SeanDS/environment-sensor/README.md

# environment-sensor
Ethernet-enabled dust particle, temperature and humidity sensor module
