SeanDS/environment-sensor/hardware/environment-sensor.kicad_pcb

## KiCad design hardware/environment-sensor.kicad_pcb (2017-10-11)

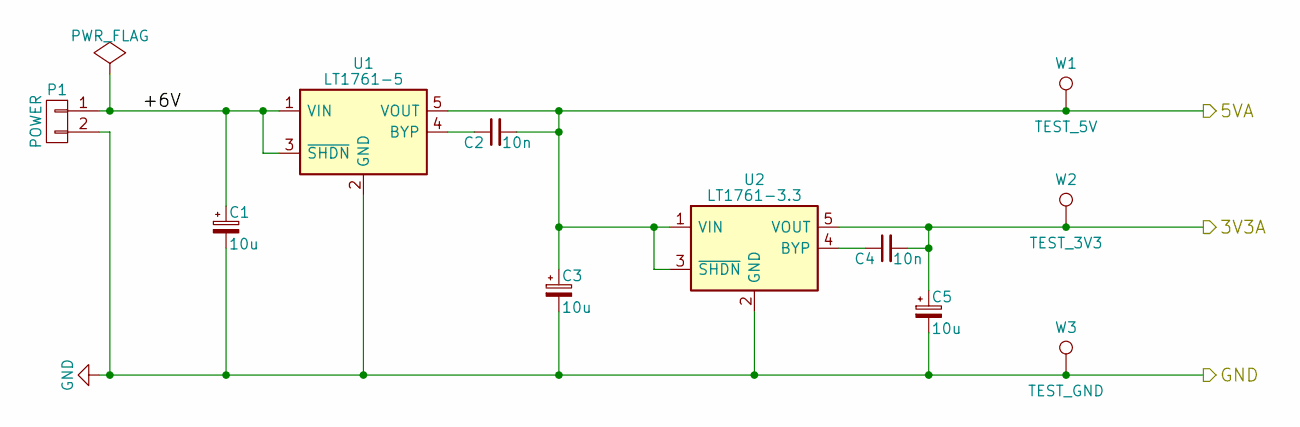
[picture p1: schematic power.sch]

Parts:
C1, C3, C5: 10u; C_Radial_D5_L11_P2
C2, C4: 10n; C_1206
P1: POWER; Molex_KK-6410-02_02x2.54mm_Straight
U1: LT1761-5; SOT-23-5
U2: LT1761-3.3; SOT-23-5
W1: TEST_5V; PINTST
W2: TEST_3V3; PINTST
W3: TEST_GND; PINTST

Connections:
/Microcontroller/3V3A: C4.2, C5.1, U2.5 (VOUT), W2.1; also elsewhere on the board
/Microcontroller/5VA: C2.2, C3.1, U1.5 (VOUT), U2.1 (VIN), U2.3 (~SHDN), W1.1; also elsewhere on the board
/Power Supply/+6V: C1.1, P1.1, U1.1 (VIN), U1.3 (~SHDN)
GND: C1.2, C3.2, C5.2, P1.2, U1.2 (GND), U2.2 (GND), W3.1; also elsewhere on the board
unnamed: C2.1, U1.4 (BYP)
unnamed: C4.1, U2.4 (BYP)

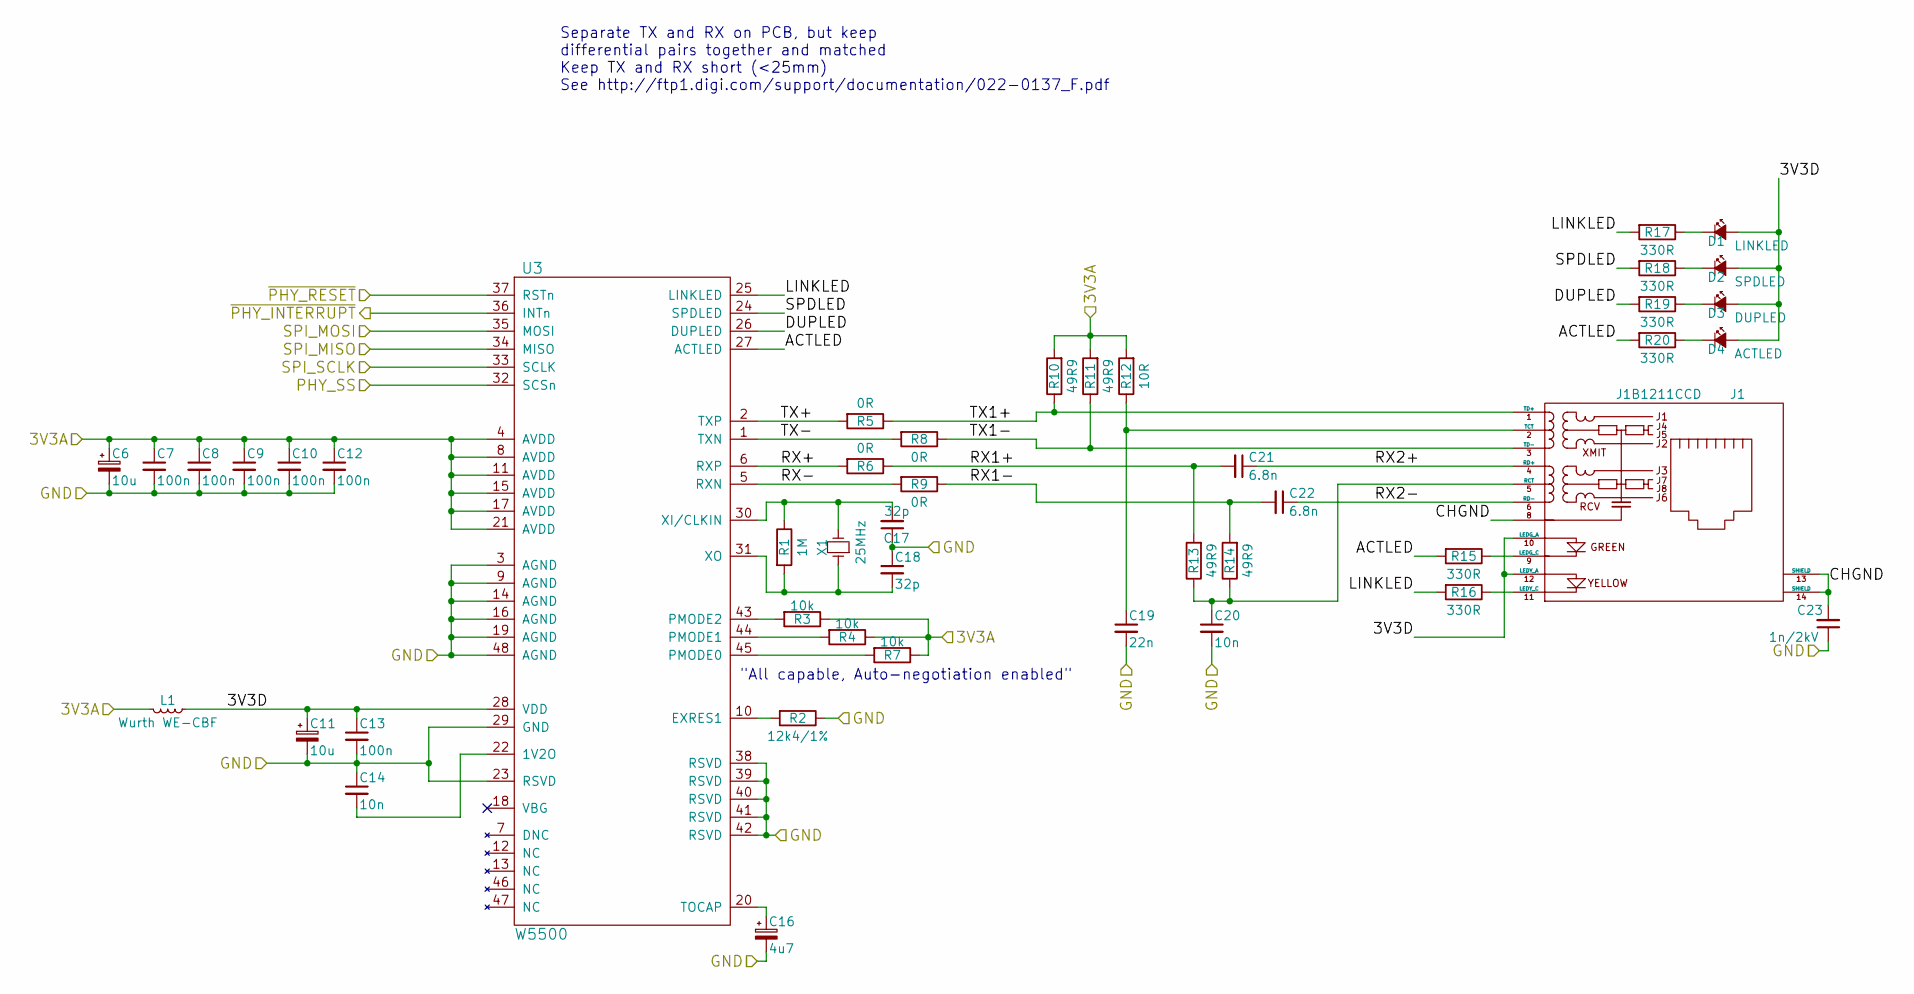
[picture p2: schematic network.sch]

Parts:
C6, C11: 10u; C_Radial_D5_L11_P2
C7, C8, C9, C10, C12, C13: 100n; C_1206
C14, C20: 10n; C_1206
C16: 4u7; C_Radial_D5_L11_P2
C17, C18: 32p; C_0603
C19: 22n; C_1206
C21, C22: 6.8n; C_1206
C23: 1n/2kV; C_1206
D1: LINKLED; LED_0805
D2: SPDLED; LED_0805
D3: DUPLED; LED_0805
D4: ACTLED; LED_0805
J1: J1B1211CCD; Cetus_J1B1211CCD
L1: Wurth WE-CBF; Choke_SMD_1206_Standard
R1: 1M; R_1206
R2: 12k4/1%; R_1206
R3, R4, R7: 10k; R_1206
R5, R6, R8, R9: 0R; R_1206
R10, R11, R13, R14: 49R9; R_1206
R12: 10R; R_1206
R15, R16, R17, R18, R19, R20: 330R; R_1206
U3: W5500; LQFP-48_7x7mm_Pitch0.5mm
X1: 25MHz; Crystal_HC49-SD_SMD

Connections:
/Microcontroller/3V3A: C6.1, C7.1, C8.1, C9.1, C10.1, C12.1, L1.2, R3.1, R4.1, R7.1, R10.2, R11.2, R12.2, U3.4 (AVDD), U3.8 (AVDD), U3.11 (AVDD), U3.15 (AVDD), U3.17 (AVDD), U3.21 (AVDD); also elsewhere on the board
/Microcontroller/PHY_SS: U3.32 (SCSn); also elsewhere on the board
/Microcontroller/SPI_MISO: U3.34 (MISO); also elsewhere on the board
/Microcontroller/SPI_MOSI: U3.35 (MOSI); also elsewhere on the board
/Microcontroller/SPI_SCLK: U3.33 (SCLK); also elsewhere on the board
/Microcontroller/~PHY_INTERRUPT: U3.36 (INTn); also elsewhere on the board
/Microcontroller/~PHY_RESET: U3.37 (RSTn); also elsewhere on the board
/Network I/O/3V3D: C11.1, C13.1, D1.2 (A), D2.2 (A), D3.2 (A), D4.2 (A), J1.10 (LEDG_A), J1.12 (LEDY_A), L1.1, U3.28 (VDD)
/Network I/O/ACTLED: R15.2, R20.2, U3.27 (ACTLED)
/Network I/O/CHGND: C23.2, J1.8, J1.13 (SHIELD), J1.14 (SHIELD)
/Network I/O/DUPLED: R19.2, U3.26 (DUPLED)
/Network I/O/LINKLED: R16.2, R17.2, U3.25 (LINKLED)
/Network I/O/RX1+: C21.2, R6.1, R13.2
/Network I/O/RX1-: C22.2, R9.1, R14.2
/Network I/O/RX2+: C21.1, J1.4 (RD+)
/Network I/O/RX2-: C22.1, J1.6 (RD-)
/Network I/O/RX+: R6.2, U3.6 (RXP)
/Network I/O/RX-: R9.2, U3.5 (RXN)
/Network I/O/SPDLED: R18.2, U3.24 (SPDLED)
/Network I/O/TX1+: J1.1 (TD+), R5.1, R10.1
/Network I/O/TX1-: J1.3 (TD-), R8.1, R11.1
/Network I/O/TX+: R5.2, U3.2 (TXP)
/Network I/O/TX-: R8.2, U3.1 (TXN)
GND: C6.2, C7.2, C8.2, C9.2, C10.2, C11.2, C12.2, C13.2, C14.1, C16.2, C17.1, C18.1, C19.2, C20.2, C23.1, R2.1, U3.3 (AGND), U3.9 (AGND), U3.14 (AGND), U3.16 (AGND), U3.19 (AGND), U3.23 (RSVD), U3.29 (GND), U3.38 (RSVD), U3.39 (RSVD), U3.40 (RSVD), U3.41 (RSVD), U3.42 (RSVD), U3.48 (AGND); also elsewhere on the board
unnamed: C14.2, U3.22 (1V2O)
unnamed: C16.1, U3.20 (TOCAP)
unnamed: C17.2, R1.1, U3.30 (XI/CLKIN), X1.2
unnamed: C18.2, R1.2, U3.31 (XO), X1.1
unnamed: C19.1, J1.2 (TCT), R12.1
unnamed: C20.1, J1.5 (RCT), R13.1, R14.1
unnamed: D1.1 (K), R17.1
unnamed: D2.1 (K), R18.1
unnamed: D3.1 (K), R19.1
unnamed: D4.1 (K), R20.1
unnamed: J1.9 (LEDG_C), R15.1
unnamed: J1.11 (LEDY_C), R16.1
unnamed: R2.2, U3.10 (EXRES1)
unnamed: R3.2, U3.43 (PMODE2)
unnamed: R4.2, U3.44 (PMODE1)
unnamed: R7.2, U3.45 (PMODE0)

Notes on the sheet:
"All capable, Auto-negotiation enabled"
Separate TX and RX on PCB, but keep differential pairs together and matched Keep TX and RX short (<25mm) See http://ftp1.digi.com/support/documentation/022-0137_F.pdf

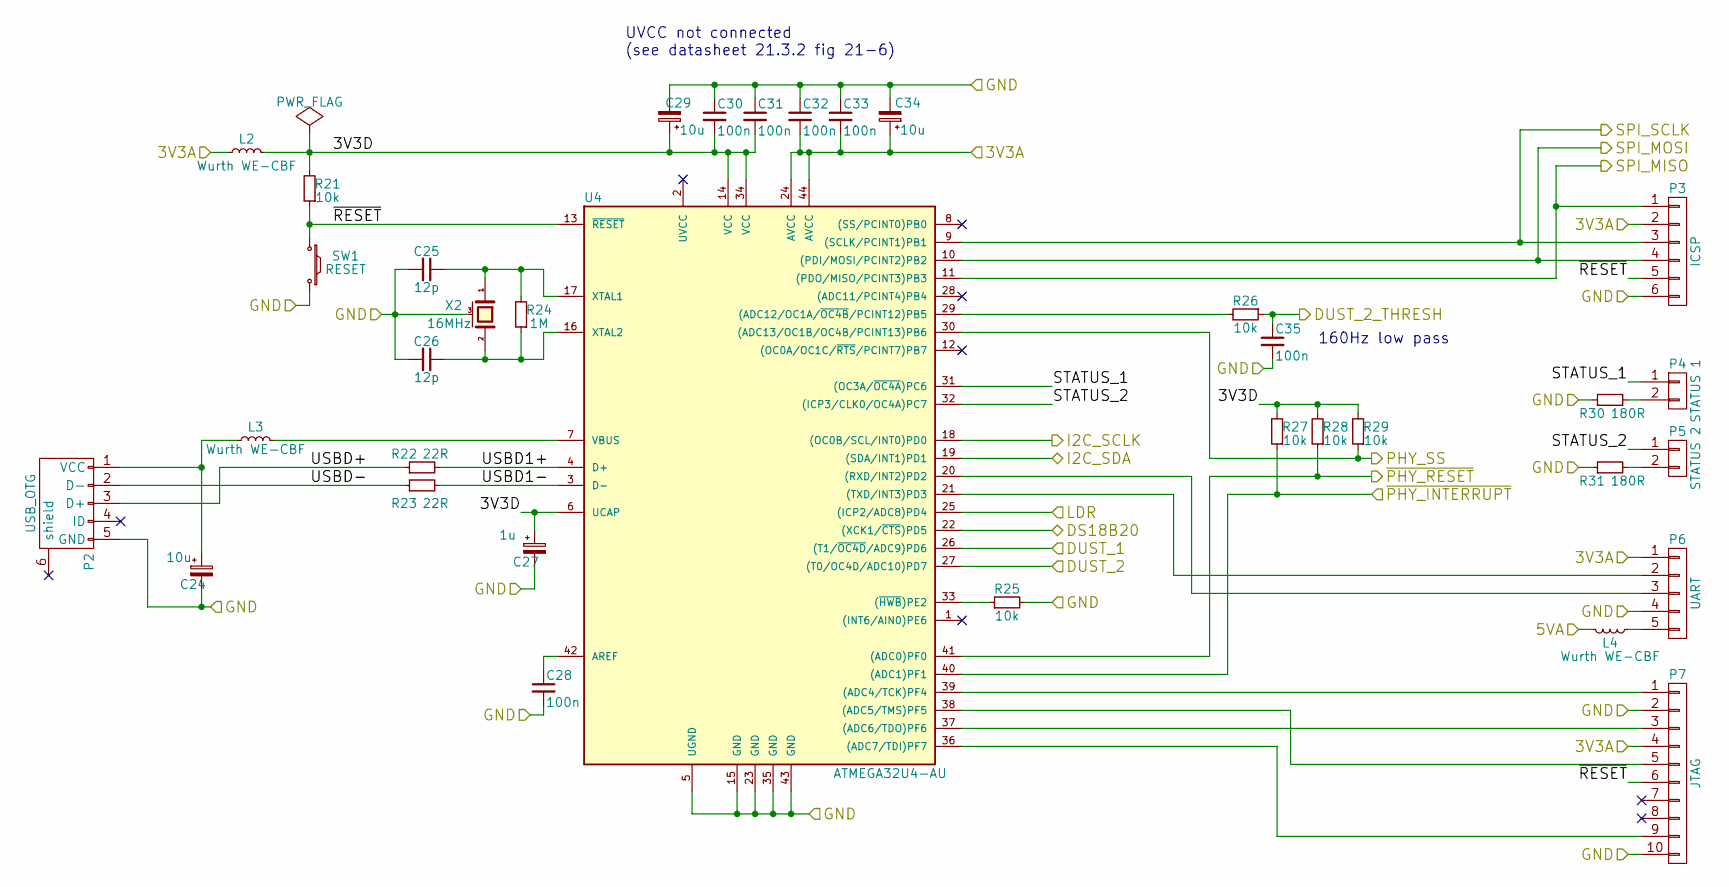
[picture p3: schematic microcontroller.sch]

Parts:
C24, C29, C34: 10u; C_Radial_D5_L11_P2
C25, C26: 12p; C_0603
C27: 1u; C_Radial_D5_L11_P2
C28, C30, C31, C32, C33, C35: 100n; C_1206
L2, L3, L4: Wurth WE-CBF; Choke_SMD_1206_Standard
P2: USB_OTG; USB_Micro-B_10103594-0001LF
P3: ICSP; Pin_Header_Straight_2x03
P4: STATUS 1; Molex_KK-6410-02_02x2.54mm_Straight
P5: STATUS 2; Molex_KK-6410-02_02x2.54mm_Straight
P6: UART; Pin_Header_Straight_1x05
P7: JTAG; Pin_Header_Straight_2x05_Pitch1.27mm
R21, R25, R26, R27, R28, R29: 10k; R_1206
R22, R23: 22R; R_1206
R24: 1M; R_1206
R30, R31: 180R; R_1206
SW1: RESET; SW_SPST_FSM_JSM; MPN1 4-1437565-1
U4: ATMEGA32U4-AU; TQFP-44_10x10mm_Pitch0.8mm
X2: 16MHz; crystal_FA238-TSX3225

Connections:
/Microcontroller/3V3A: C32.2, C33.2, C34.1, L2.1, P3.2, P6.1, P7.4, U4.24 (AVCC), U4.44 (AVCC); also elsewhere on the board
/Microcontroller/3V3D: C27.1, C29.1, C30.2, C31.2, L2.2, R21.2, R27.2, R28.2, R29.2, U4.6 (UCAP), U4.14 (VCC), U4.34 (VCC)
/Microcontroller/5VA: L4.2; also elsewhere on the board
/Microcontroller/DS18B20: U4.22 ((XCK1/~CTS~)PD5); also elsewhere on the board
/Microcontroller/DUST_1: U4.26 ((T1/~OC4D~/ADC9)PD6); also elsewhere on the board
/Microcontroller/DUST_2: U4.27 ((T0/OC4D/ADC10)PD7); also elsewhere on the board
/Microcontroller/DUST_2_THRESH: C35.1, R26.1; also elsewhere on the board
/Microcontroller/I2C_SCLK: U4.18 ((OC0B/SCL/INT0)PD0); also elsewhere on the board
/Microcontroller/I2C_SDA: U4.19 ((SDA/INT1)PD1); also elsewhere on the board
/Microcontroller/LDR: U4.25 ((ICP2/ADC8)PD4); also elsewhere on the board
/Microcontroller/PHY_SS: R29.1, U4.30 ((ADC13/OC1B/OC4B/PCINT13)PB6); also elsewhere on the board
/Microcontroller/SPI_MISO: P3.1, U4.11 ((PDO/MISO/PCINT3)PB3); also elsewhere on the board
/Microcontroller/SPI_MOSI: P3.4, U4.10 ((PDI/MOSI/PCINT2)PB2); also elsewhere on the board
/Microcontroller/SPI_SCLK: P3.3, U4.9 ((SCLK/PCINT1)PB1); also elsewhere on the board
/Microcontroller/STATUS_1: P4.1, U4.31 ((OC3A/~OC4A~)PC6)
/Microcontroller/STATUS_2: P5.1, U4.32 ((ICP3/CLK0/OC4A)PC7)
/Microcontroller/USBD1+: R22.2, U4.4 (D+)
/Microcontroller/USBD1-: R23.2, U4.3 (D-)
/Microcontroller/USBD+: P2.3 (D+), R22.1
/Microcontroller/USBD-: P2.2 (D-), R23.1
/Microcontroller/~PHY_INTERRUPT: R27.1, U4.40 ((ADC1)PF1); also elsewhere on the board
/Microcontroller/~PHY_RESET: R28.1, U4.41 ((ADC0)PF0); also elsewhere on the board
/Microcontroller/~RESET: P3.5, P7.6, R21.1, SW1.1, U4.13 (~RESET~)
GND: C24.2, C25.2, C26.2, C27.2, C28.2, C29.2, C30.1, C31.1, C32.1, C33.1, C34.2, C35.2, P2.5 (GND), P3.6, P6.4, P7.2, P7.10, R25.2, R30.1, R31.1, SW1.2, U4.5 (UGND), U4.15 (GND), U4.23 (GND), U4.35 (GND), U4.43 (GND), X2.3 (case); also elsewhere on the board
unnamed: C24.1, L3.1, P2.1 (VCC)
unnamed: C25.1, R24.2, U4.17 (XTAL1), X2.1
unnamed: C26.1, R24.1, U4.16 (XTAL2), X2.2
unnamed: C28.1, U4.42 (AREF)
unnamed: L3.2, U4.7 (VBUS)
unnamed: L4.1, P6.5
unnamed: P4.2, R30.2
unnamed: P5.2, R31.2
unnamed: P6.2, U4.21 ((TXD/INT3)PD3)
unnamed: P6.3, U4.20 ((RXD/INT2)PD2)
unnamed: P7.1, U4.39 ((ADC4/TCK)PF4)
unnamed: P7.3, U4.37 ((ADC6/TDO)PF6)
unnamed: P7.5, U4.38 ((ADC5/TMS)PF5)
unnamed: P7.9, U4.36 ((ADC7/TDI)PF7)
unnamed: R25.1, U4.33 ((~HWB~)PE2)
unnamed: R26.2, U4.29 ((ADC12/OC1A/~OC4B~/PCINT12)PB5)

Notes on the sheet:
160Hz low pass
UVCC not connected (see datasheet 21.3.2 fig 21-6)

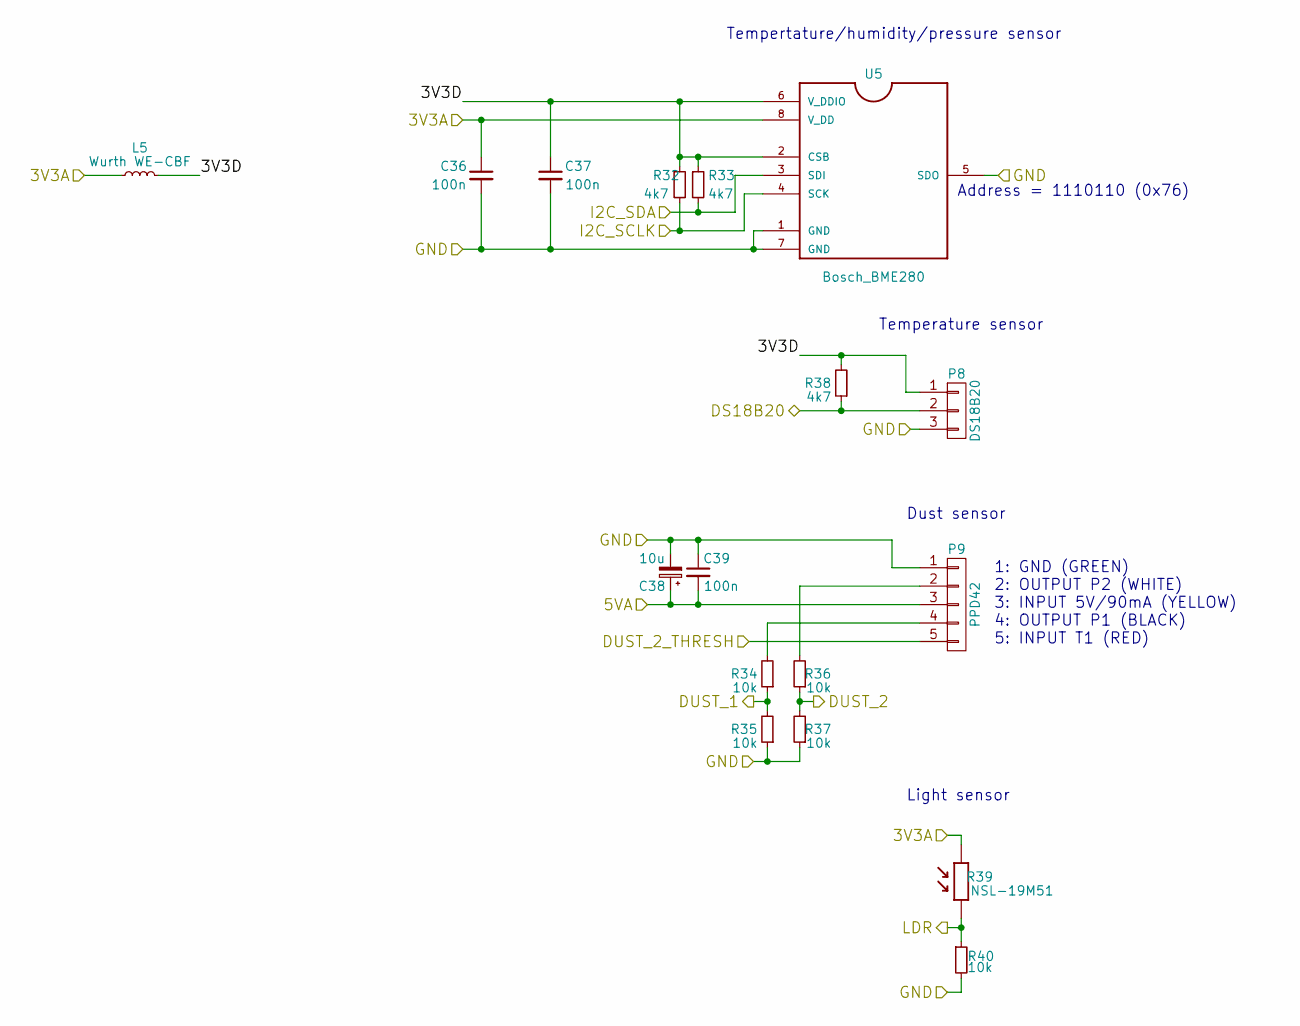
[picture p4: schematic sensors.sch]

Parts:
C36, C37, C39: 100n; C_1206
C38: 10u; C_Radial_D5_L11_P2
L5: Wurth WE-CBF; Choke_SMD_1206_Standard
P8: DS18B20; Molex_KK-6410-03_03x2.54mm_Straight
P9: PPD42; Molex_KK-6410-05_05x2.54mm_Straight
R32, R33, R38: 4k7; R_1206
R34, R35, R36, R37, R40: 10k; R_1206
R39: NSL-19M51; NSL_19M51; MPN1 NSL-19M51
U5: Bosch_BME280; Bosch_BME280_LGA-8

Connections:
/Microcontroller/3V3A: C36.1, L5.1, R39.2, U5.8 (V_DD); also elsewhere on the board
/Microcontroller/5VA: C38.1, C39.2, P9.3; also elsewhere on the board
/Microcontroller/DS18B20: P8.2, R38.1; also elsewhere on the board
/Microcontroller/DUST_1: R34.1, R35.2; also elsewhere on the board
/Microcontroller/DUST_2: R36.1, R37.2; also elsewhere on the board
/Microcontroller/DUST_2_THRESH: P9.5; also elsewhere on the board
/Microcontroller/I2C_SCLK: R32.2, U5.4 (SCK); also elsewhere on the board
/Microcontroller/I2C_SDA: R33.2, U5.3 (SDI); also elsewhere on the board
/Microcontroller/LDR: R39.1, R40.1; also elsewhere on the board
/Sensors/3V3D: C37.1, L5.2, P8.1, R32.1, R33.1, R38.2, U5.2 (CSB), U5.6 (V_DDIO)
GND: C36.2, C37.2, C38.2, C39.1, P8.3, P9.1, R35.1, R37.1, R40.2, U5.1 (GND), U5.5 (SDO), U5.7 (GND); also elsewhere on the board
unnamed: P9.2, R36.2
unnamed: P9.4, R34.2

Notes on the sheet:
Address = 1110110 (0x76)
1: GND (GREEN) 2: OUTPUT P2 (WHITE) 3: INPUT 5V/90mA (YELLOW) 4: OUTPUT P1 (BLACK) 5: INPUT T1 (RED)
Dust sensor
Light sensor
Tempertature/humidity/pressure sensor
Temperature sensor

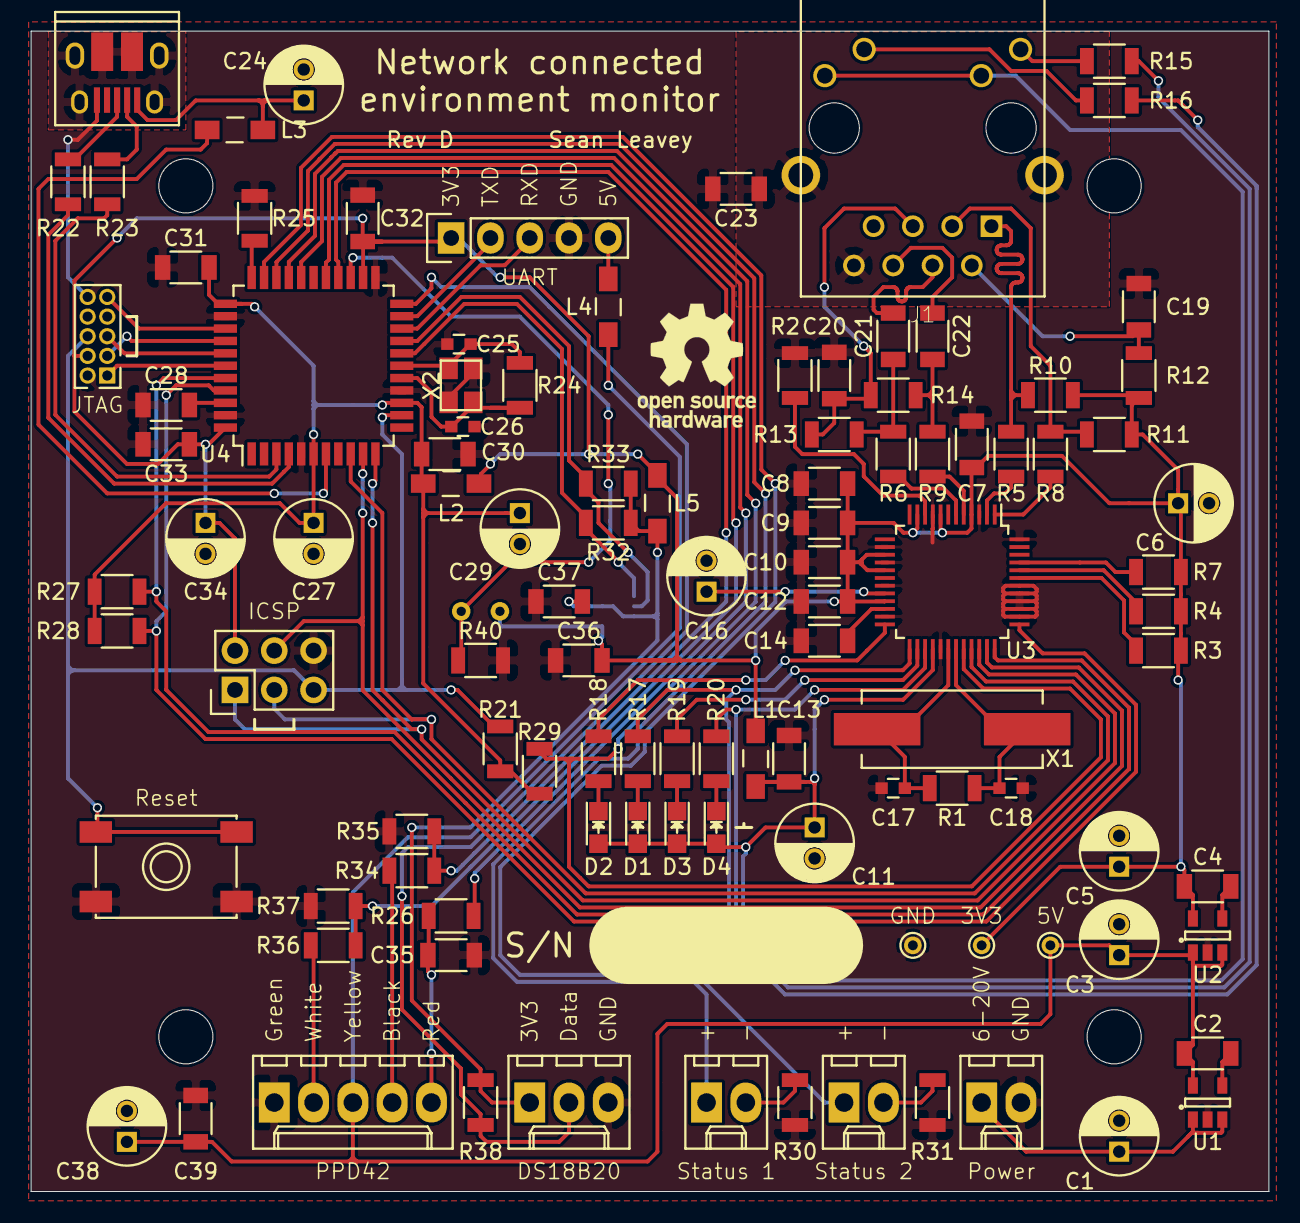
[picture p5: board environment-sensor.kicad_pcb from above]

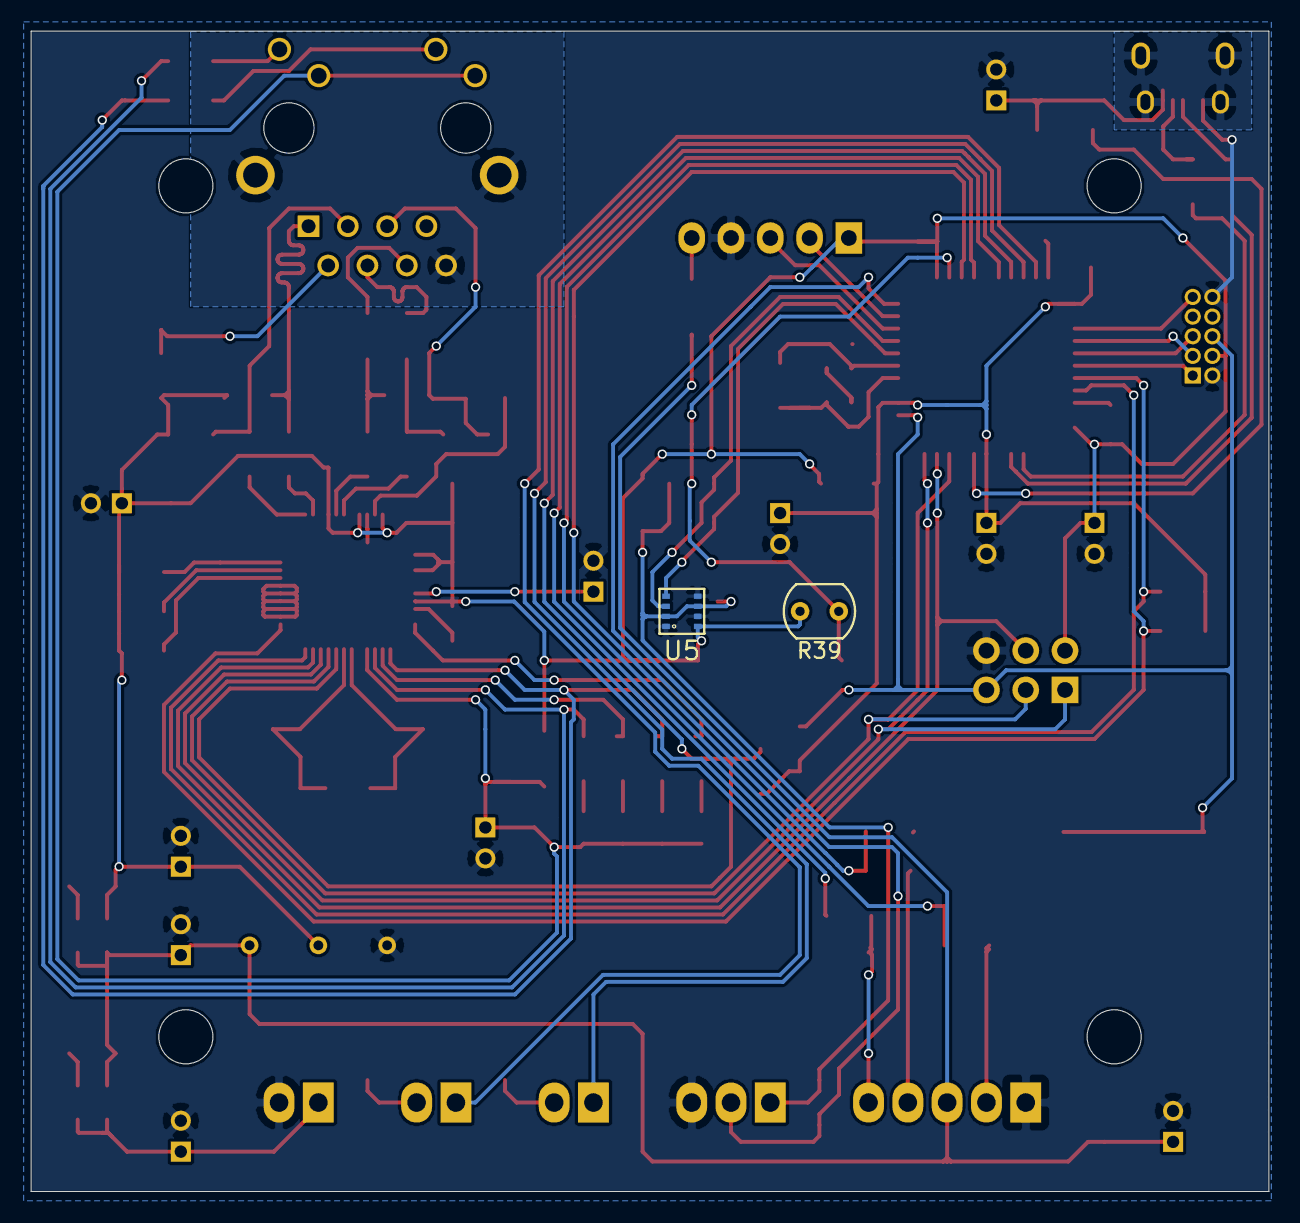
[picture p6: board environment-sensor.kicad_pcb from below]

Board: 2 copper layers, 80.0 x 75.0 mm, 109 parts (2 on the bottom side), 78 nets.

Other parts of the board:
Ref**: Val**; 80mmx75mm_holes
