SeanDS/environment-sensor/hardware/environment-sensor-v1.0.kicad_pcb

## KiCad design hardware/environment-sensor-v1.0.kicad_pcb (2017-06-20, an earlier design)

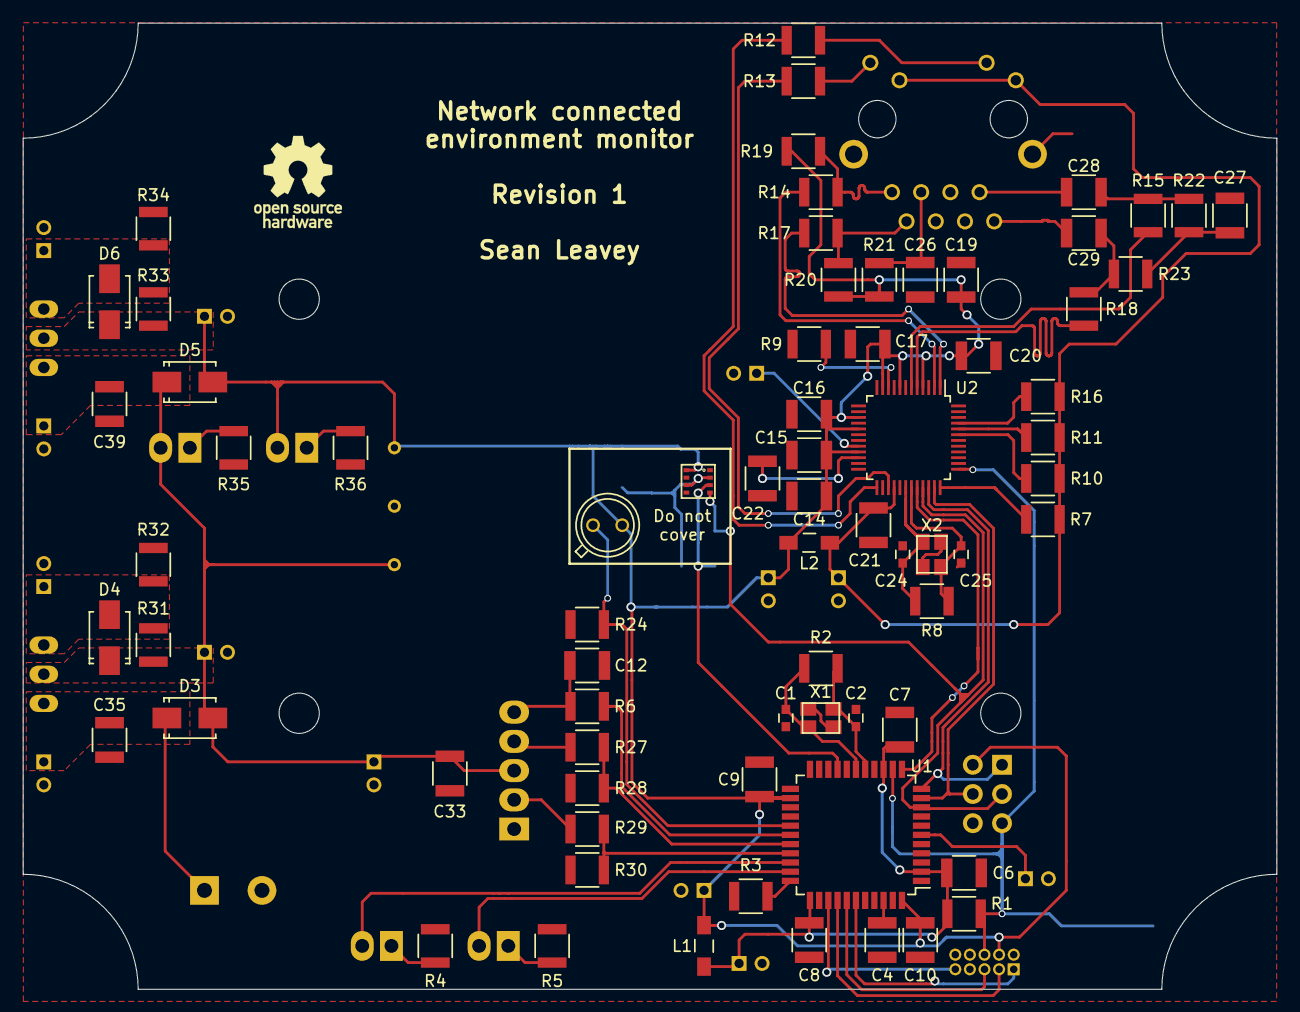
[picture p7: board environment-sensor-v1.0.kicad_pcb from above]

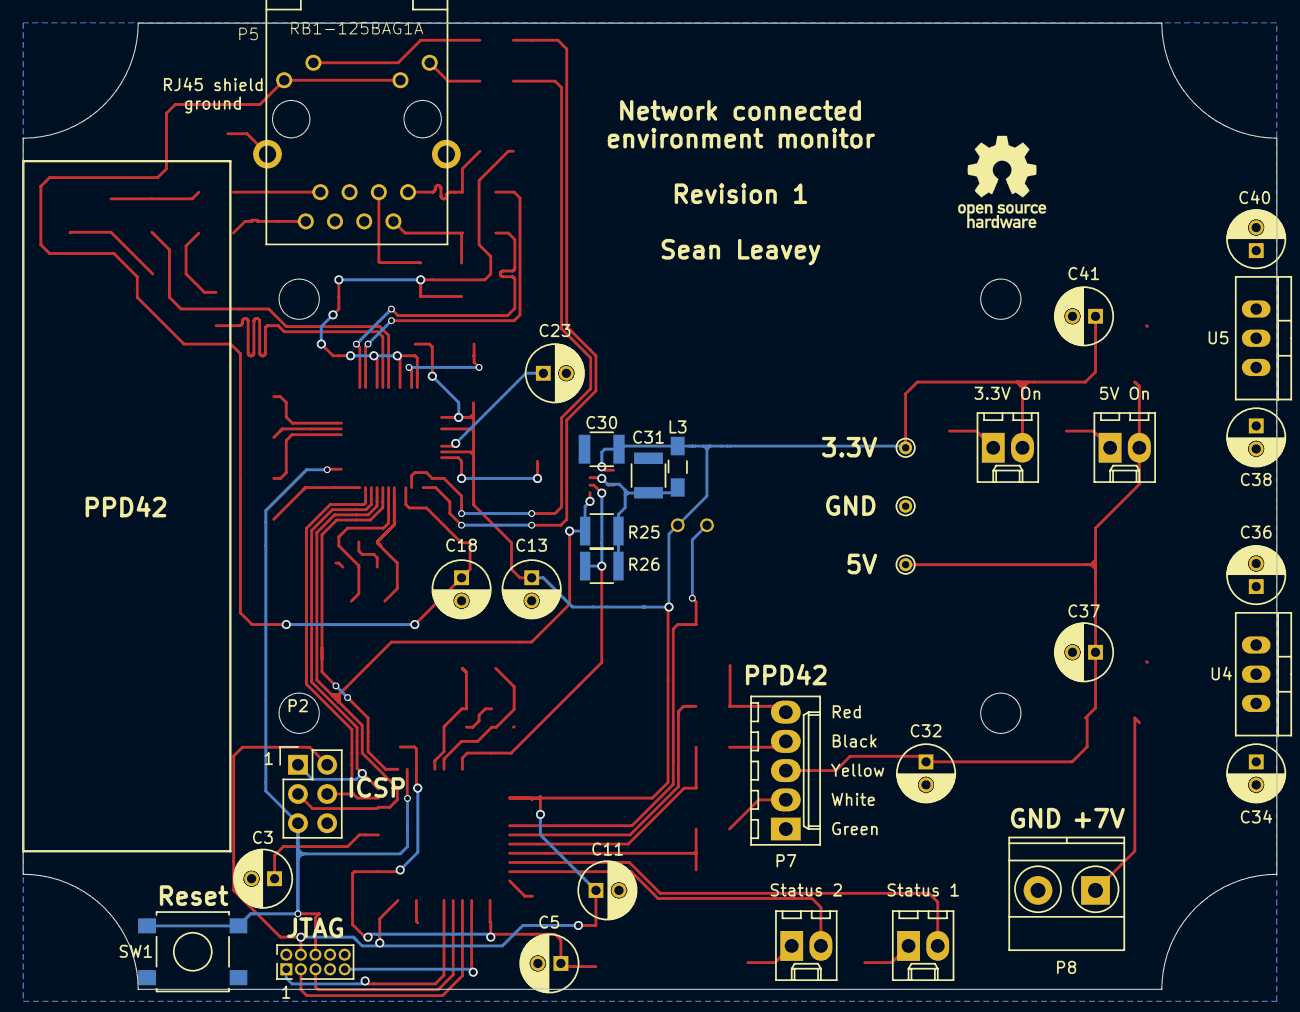
[picture p8: board environment-sensor-v1.0.kicad_pcb from below]

Board: 2 copper layers, 109.0 x 84.0 mm, 106 parts (33 on the bottom side), 62 nets.

Parts:
C1, C2, C24, C25: 12p; C_0603
C3, C5, C11, C13, C18, C32, C34, C36, C37, C38, C40, C41: 10u; C_Radial_D5_L11_P2
C4, C6, C7, C8, C9, C10, C12, C14, C15, C16, C17, C19, C20, C21, C26, C30, C31, C33, C35, C39: 100n; C_1210
C22, C27, C28, C29: 10n; C_1210
C23: 4u7; C_Radial_D5_L11_P2
D1: Status 1; Molex_KK-6410-02_02x2.54mm_Straight
D2: Status 2; Molex_KK-6410-02_02x2.54mm_Straight
D3, D4, D5, D6: S1B-13-F; SMA_Standard
D7: LED_5V; Molex_KK-6410-02_02x2.54mm_Straight
D8: LED_3V3; Molex_KK-6410-02_02x2.54mm_Straight
L1, L2, L3: Wurth WE-CBF; Choke_SMD_1206_Standard
P2: ICSP; Pin_Header_Straight_2x03
P4: JTAG; Pin_Header_Straight_2x05_Pitch1.27mm
P5: RB1-125BAG1A; WIZNET_RB1-125BAG1A
P6: NSL-19M51; TO-18_2Pin
P7: PPD42; Molex_KK-6410-05_05x2.54mm_Straight
P8: POWER; TerminalBlock_Pheonix_MKDS1.5-2pol
R1, R3, R6, R7, R10, R11, R16, R24, R27, R28, R29, R30: 10k; R_1210
R2, R8: 1M; R_1210
R4, R5, R34, R36: 180R; R_1210
R9: 12k4/1%; R_1210
R12, R13, R32: 330R; R_1210
R14, R15, R17, R18: 33R; R_1210
R19, R20, R22, R23: 49R9/1%; R_1210
R21: 10R/1%; R_1210
R25, R26: 4k7; R_1210
R31, R33: 110R; R_1210
R35: 270R; R_1210
Ref**: Val**; 109mmx84mm_holes
SW1: Reset; SW_SPST_B3S-1000
U1: ATMEGA32U4-AU; TQFP-44_10x10mm_Pitch0.8mm
U2: W5500; LQFP-48_7x7mm_Pitch0.5mm
U3: Bosch_BME280; Bosch_BME280_LGA-8
U4, U5: LM317T; TO-220_Neutral123_Vertical
W1: TEST_5V; PINTST
W2: TEST_3V3; PINTST
W3: TEST_GND; PINTST
X1: 16MHz; crystal_FA238-TSX3225
X2: 25MHz; crystal_FA238-TSX3225

Connections:
/Microcontroller/3V3A: C9.2, C10.2, C11.1, C13.1, C14.1, C15.1, C16.1, C17.1, C19.1, C20.1, C30.1, C41.1, D5.2, D6.1, D8.2, L1.1, L2.1, L3.1, P2.2, P4.4, P6.1, R19.2, R20.2, R21.2, R33.1, U1.24, U1.44, U2.4, U2.8, U2.11, U2.15, U2.17, U2.21, U3.8, U5.2, W2.1
/Microcontroller/3V3D: C5.1, C6.2, C7.2, C8.2, L1.2, R1.1, U1.2, U1.14, U1.34
/Microcontroller/LDR_OUT: P6.2, R24.1, U1.27
/Microcontroller/MISO: P2.1, U1.11, U2.34
/Microcontroller/MOSI: P2.4, U1.10, U2.35
/Microcontroller/P_OUT_1: R27.1, R28.2, U1.29
/Microcontroller/P_OUT_2: R29.1, R30.2, U1.30
/Microcontroller/P_THRESH: C12.1, P7.5, R6.1
/Microcontroller/SCLK: P2.3, R25.2, U1.9, U2.33, U3.4
/Microcontroller/SDA: R26.2, U1.19, U3.3
/Microcontroller/SS_PHY: U1.12, U2.32
/Microcontroller/~RESET: P2.5, P4.6, R1.2, SW1.1, U1.13, U2.37
/Network I/O/3V3D: C18.1, C21.1, L2.2, P5.L1, P5.L3, R7.1, R10.1, R11.1, R16.1, U2.28
/Network I/O/ACTLED: P5.L4, R13.1
/Network I/O/LINKLED: P5.L2, R12.1
/Network I/O/RX1+: C28.2, R15.1, R22.2
/Network I/O/RX1-: C29.2, R18.1, R23.2
/Network I/O/RX2+: C28.1, P5.R7
/Network I/O/RX2-: C29.1, P5.R8
/Network I/O/RX+: R15.2, U2.6
/Network I/O/RX-: R18.2, U2.5
/Network I/O/TX1+: P5.R1, R14.1, R19.1
/Network I/O/TX1-: P5.R2, R17.1, R20.1
/Network I/O/TX+: R14.2, U2.2
/Network I/O/TX-: R17.2, U2.1
/Power Supply/5VA: C32.1, C33.2, C37.1, C38.1, C39.1, D3.2, D4.1, D5.1, D7.2, P7.3, R31.1, U4.2, U5.3, W1.1
/Power Supply/+6V: C34.1, C35.1, D3.1, P8.1, U4.3
/Sensors/3V3D: C31.1, L3.2, R25.1, R26.1, U3.2, U3.6
GND: C1.2, C2.2, C3.2, C4.2, C5.2, C6.1, C7.1, C8.1, C9.1, C10.1, C11.2, C12.2, C13.2, C14.2, C15.2, C16.2, C17.2, C18.2, C19.2, C20.2, C21.2, C22.1, C23.2, C24.1, C25.1, C26.2, C27.2, C30.2, C31.2, C32.2, C33.1, C34.2, C35.2, C36.2, C37.2, C38.2, C39.2, C40.2, C41.2, P2.6, P4.2, P4.10, P7.1, P8.2, R3.1, R4.1, R5.1, R9.1, R24.2, R28.1, R30.1, R32.2, R34.2, R35.2, R36.2, SW1.2, U1.5, U1.15, U1.23, U1.35, U1.43, U2.3, U2.9, U2.14, U2.16, U2.19, U2.29, U2.48, U3.1, U3.5, U3.7, W3.1, X1.3, X2.3
unnamed: C1.1, R2.1, U1.17, X1.1
unnamed: C2.1, R2.2, U1.16, X1.2
unnamed: C3.1, U1.6
unnamed: C4.1, U1.42
unnamed: C22.2, U2.22
unnamed: C23.1, U2.20
unnamed: C24.2, R8.1, U2.30, X2.2
unnamed: C25.2, R8.2, U2.31, X2.1
unnamed: C26.1, P5.R3, R21.1
unnamed: C27.1, R22.1, R23.1
unnamed: C36.1, D4.2, R31.2, R32.1, U4.1
unnamed: C40.1, D6.2, R33.2, R34.1, U5.1
unnamed: D1.1, R4.2
unnamed: D1.2, U1.31
unnamed: D2.1, R5.2
unnamed: D2.2, U1.32
unnamed: D7.1, R35.1
unnamed: D8.1, R36.1
unnamed: P4.1, U1.39
unnamed: P4.3, U1.37
unnamed: P4.5, U1.38
unnamed: P4.9, U1.36
unnamed: P7.2, R29.2
unnamed: P7.4, R27.2
unnamed: R3.2, U1.33
unnamed: R6.2, U1.28
unnamed: R7.2, U2.36
unnamed: R9.2, U2.10
unnamed: R10.2, U2.43
unnamed: R11.2, U2.44
unnamed: R12.2, U2.25
unnamed: R13.2, U2.27
unnamed: R16.2, U2.45
