SeanDS/environment-sensor/(commit log)

2017-04-17 Work on schematic
    [environment-sensor.kicad_pcb, environment-sensor.sch, microcontroller.sch, network.sch, power.sch, sensors.sch]
2017-05-01 Almost finished layout
    [environment-sensor.kicad_pcb, environment-sensor.sch, microcontroller.sch, network.sch, power.sch, sensors.sch]
2017-05-01 Add planes for regulators
    [environment-sensor.kicad_pcb]
2017-05-02 Move labels, replace some SMB diodes with SMA, final tweaks
    [environment-sensor.kicad_pcb, power.sch]
2017-05-02 Move LM317 regulator footprints to underside; final tweaks
    [environment-sensor.kicad_pcb, power.sch]
2017-06-20 Revision of board to address issues
    [environment-sensor-v1.0.kicad_pcb, environment-sensor.kicad_pcb, environment-sensor.sch, microcontroller.sch, network.sch, power.sch, sensors.sch]
2017-06-21 Small update to board
    [environment-sensor.kicad_pcb]
2017-06-21 Board files for revision 2
    [environment-sensor-B.Cu.gbr, environment-sensor-B.Mask.gbr, environment-sensor-B.SilkS.gbr, environment-sensor-Edge.Cuts.gbr, environment-sensor-F.Cu.gbr, environment-sensor-F.Mask.gbr, environment-sensor-F.SilkS.gbr, environment-sensor-NPTH.drl]
2017-08-14 Further update to change clock package and move some components around
    [environment-sensor.kicad_pcb, microcontroller.sch, network.sch, power.sch]
2017-08-20 Revision to address clock issue
    [environment-sensor.kicad_pcb]
2017-09-26 Sensor readout code using virtual serial over USB
2017-09-29 Working example with DHCP, USB debugging and analog/digital sensor readings. Problem with USB in that it crashes if too much stuff is done in between calls to USB_USBTask(). Will investigate alternat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
    [adc.c, adc.h, usb.c, usb.h]
2017-09-29 Example with USB debugging via minimal Teensy library
2017-10-02 Working DHCP, sensor readouts and USB serial
2017-10-02 USB line printer with carriage return; PWM output for dust sensor; cleanup
2017-10-04 Move data timer overflow counter into its own loop
2017-10-05 JSON encoded sensor data; smaller buffers; better memory use
2017-10-06 Socket no longer closed during normal operation - this is reserved for errors since it generates [RST, ACK] TCP flags as opposed to e.g. [FIN, ACK].
    [sensor.c, sensor.h]
2017-10-09 Update footprints and parts
2017-10-10 New revision to board
    [environment-sensor.kicad_pcb, environment-sensor.sch, microcontroller.sch, network.sch, power.sch, sensors.sch]
2017-10-11 Finishing tweaks to revision 4
    [environment-sensor.kicad_pcb]
2017-10-11 Board files for revision 4
    [environment-sensor-B.Cu.gbr, environment-sensor-B.Mask.gbr, environment-sensor-B.SilkS.gbr, environment-sensor-Edge.Cuts.gbr, environment-sensor-F.Cu.gbr, environment-sensor-F.Mask.gbr, environment-sensor-F.SilkS.gbr, environment-sensor-NPTH.drl]
2017-10-11 Board files for revision 3 (from August)
    [environment-sensor-B.Cu.gbr, environment-sensor-B.Mask.gbr, environment-sensor-B.SilkS.gbr, environment-sensor-Edge.Cuts.gbr, environment-sensor-F.Cu.gbr, environment-sensor-F.Mask.gbr, environment-sensor-F.SilkS.gbr, environment-sensor-NPTH.drl]
2017-10-11 Board files for revision 3
    [environment-sensor-B.Cu.gbr, environment-sensor-B.Mask.gbr, environment-sensor-B.SilkS.gbr, environment-sensor-Edge.Cuts.gbr, environment-sensor-F.Cu.gbr, environment-sensor-F.Mask.gbr, environment-sensor-F.SilkS.gbr, environment-sensor-NPTH.drl]
2017-10-12 Added some part numbers to the schematic
    [environment-sensor.sch, microcontroller.sch, network.sch, power.sch, sensors.sch]
